PurdueROV-Archive/PCB-X8-Micro/Micro/Gerber/README.txt

Samuel Deghuee
Sdeghuee@gmail.com
(408)693-8003
1/16/2016
STM32f407layout
X:61.43 Y: 90.98 (mm)
Area:5,588.9 mm^2
