PurdueROV-Archive/PCB-X8-Micro/Micro/eagleUp/eagleUp_STM32f407layout_bottom_mask.png

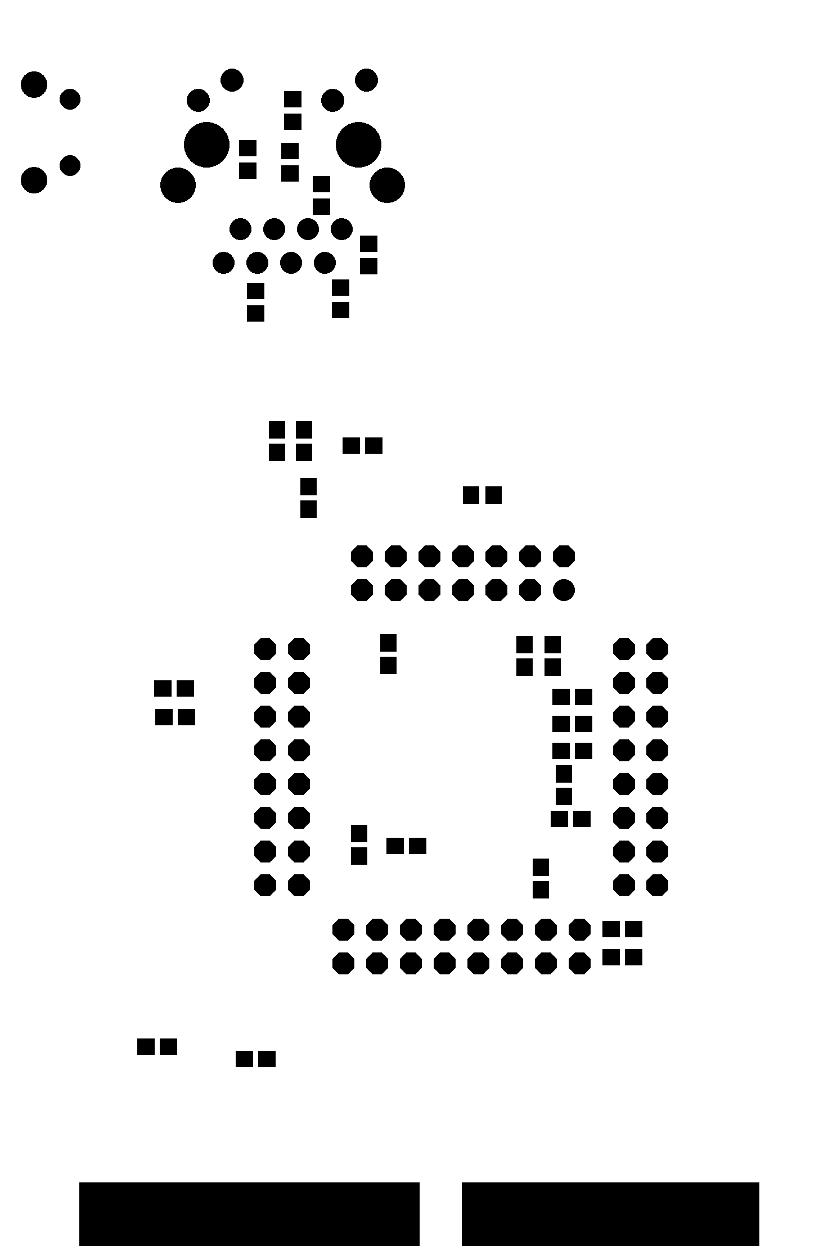
Micro/eagleUp/eagleUp_STM32f407layout_bottom_mask.png
