PurdueROV-Archive/PCB-X8-Micro/Micro/eagleUp/eagleUp_STM32f407layout_top.png

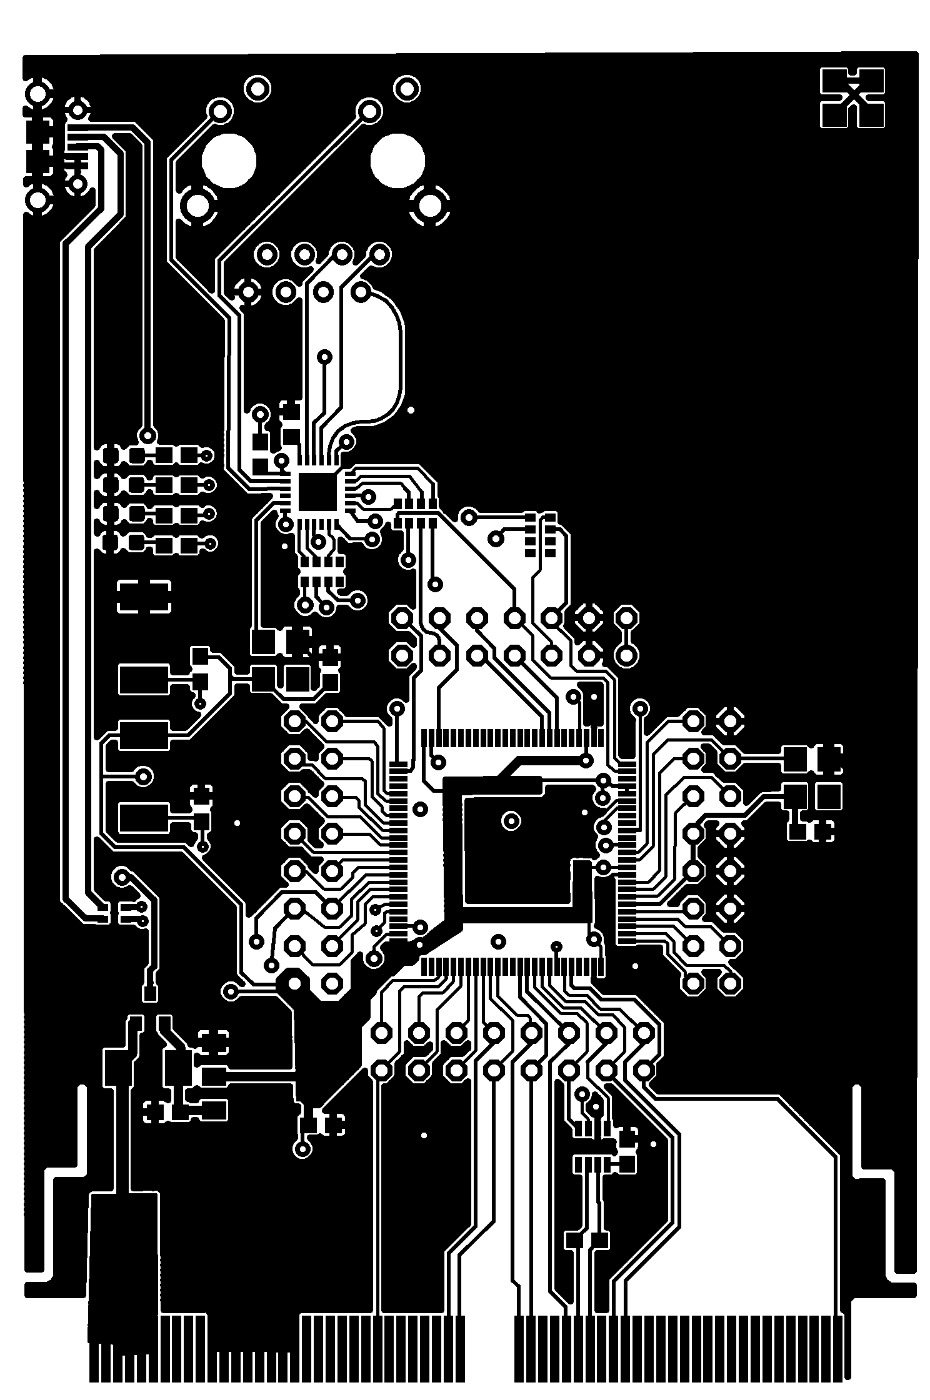
Micro/eagleUp/eagleUp_STM32f407layout_top.png
