PurdueROV-Archive/PCB-X8-Micro/Ethernet Chip/ethernet board/ethernet_chip_board.brd

## EAGLE design Ethernet Chip/ethernet board/ethernet_chip_board.brd (2015-12-05)

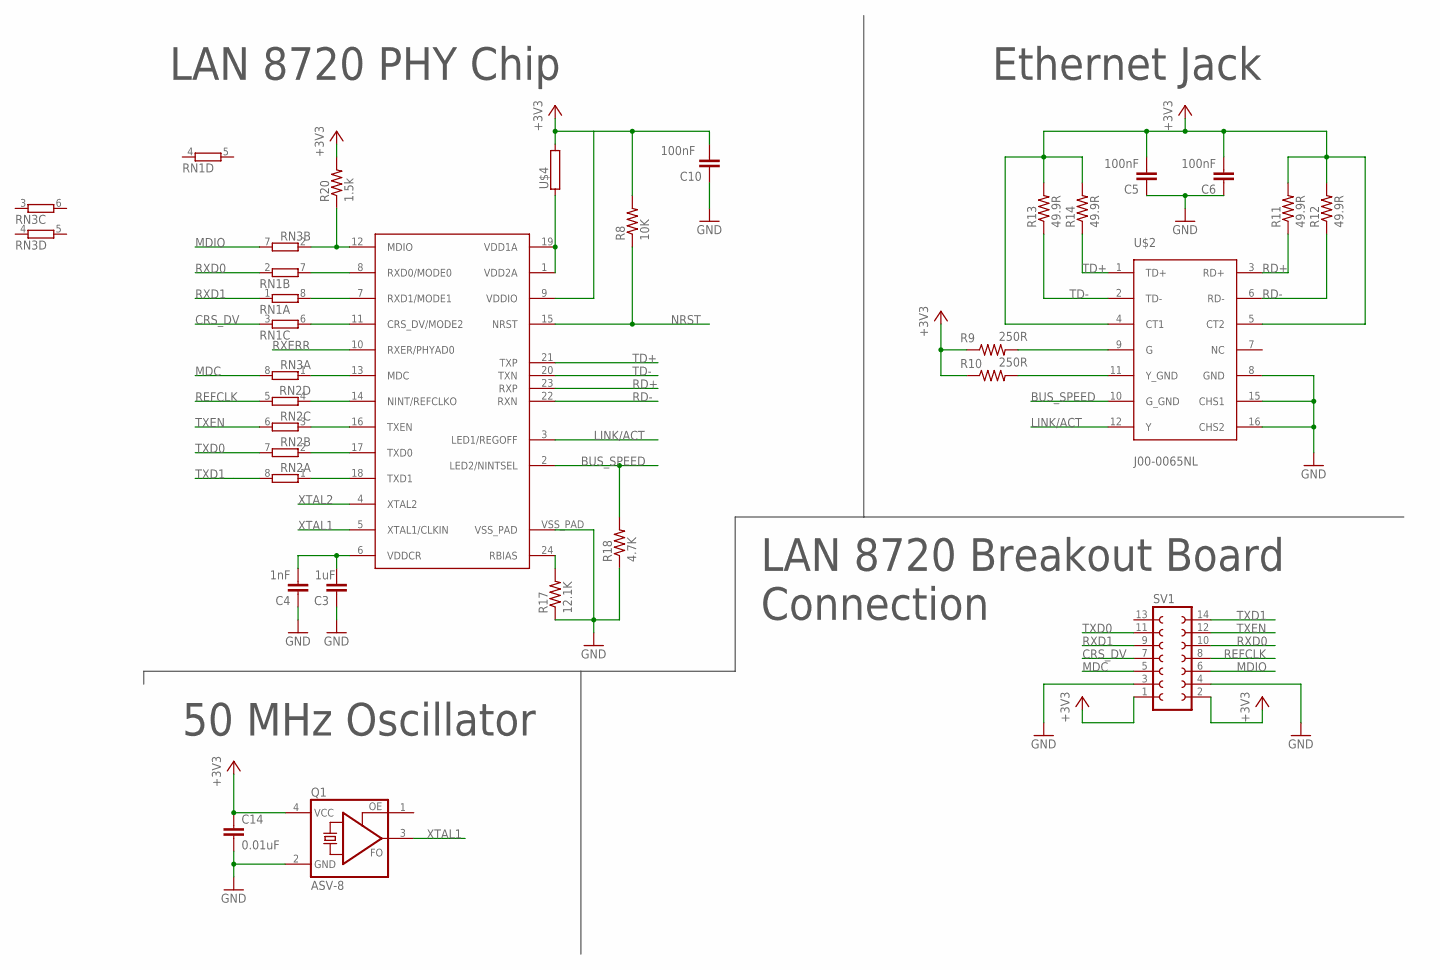
[picture p13: schematic ethernet_chip_board.sch]

Parts:
C3: 1uF; C0603
C4: 1nF; C0603
C5, C6, C10: 100nF; C0603
C14: 0.01uF; C0603
Q1: ASV-8; ASF
R8: 10K; 0603-RES
R9, R10: 250R; R0603
R11, R12, R13, R14: 49.9R; R0603
R17: 12.1K; R0603
R18: 4.7K; R0603
R20: 1.5k; R0603
RN1, RN2, RN3: 4R-NCAY16; CAY16
SV1: FE07-2
U$1: LAN8720LAN8720; 24-QFN
U$2: J00-0065NL
U$4: 553-2382-1-ND; 0603

Connections:
+3V3: C5.2, C6.2, C10.2, C14.1, Q1.4 (VCC), R8.2, R9.1, R10.1, R11.2, R12.2, R13.2, R14.2, R20.2, SV1.1, SV1.2, U$1.9 (VDDIO), U$2.4 (CT1), U$2.5 (CT2), U$4.2
BUS_SPEED: R18.2, U$1.2 (LED2/NINTSEL), U$2.10 (G_GND)
CRS_DV: RN1.3 (1), SV1.7
GND: C3.1, C4.1, C5.1, C6.1, C10.1, C14.2, Q1.2 (GND), R17.1, R18.1, SV1.3, SV1.4, U$1.VSS_PAD, U$2.8 (GND), U$2.15 (CHS1), U$2.16 (CHS2)
GREEN: R9.2, U$2.9 (G)
LINK/ACT: U$1.3 (LED1/REGOFF), U$2.12 (Y)
MDC: RN3.8 (2), SV1.5
MDE: RN3.1, U$1.13 (MDC)
MDIO: RN3.7 (2), SV1.6
unnamed: RN1.7 (2), U$1.8 (RXD0/MODE0)
unnamed: RN1.8 (2), U$1.7 (RXD1/MODE1)
unnamed: C3.2, C4.2, U$1.6 (VDDCR)
unnamed: R17.2, U$1.24 (RBIAS)
unnamed: RN1.6 (2), U$1.11 (CRS_DV/MODE2)
unnamed: RN2.4 (1), U$1.14 (NINT/REFCLKO)
unnamed: RN2.3 (1), U$1.16 (TXEN)
unnamed: RN2.2 (1), U$1.17 (TXD0)
unnamed: RN2.1, U$1.18 (TXD1)
unnamed: U$1.1 (VDD2A), U$1.19 (VDD1A), U$4.1
unnamed: R20.1, RN3.2 (1), U$1.12 (MDIO)
NRST: R8.1, U$1.15 (NRST)
RD+: R11.1, U$1.23 (RXP), U$2.3 (RD+)
RD-: R12.1, U$1.22 (RXN), U$2.6 (RD-)
REFCLK: RN2.5 (2), SV1.8
RXD0: RN1.2 (1), SV1.10
RXD1: RN1.1, SV1.9
RXERR: U$1.10 (RXER/PHYAD0)
TD+: R14.1, U$1.21 (TXP), U$2.1 (TD+)
TD-: R13.1, U$1.20 (TXN), U$2.2 (TD-)
TXD0: RN2.7 (2), SV1.11
TXD1: RN2.8 (2), SV1.14
TXEN: RN2.6 (2), SV1.12
XTAL1: Q1.3 (FO), U$1.5 (XTAL1/CLKIN)
XTAL2: U$1.4 (XTAL2)
YELLOW: R10.2, U$2.11 (Y_GND)

Notes on the sheet:
Ethernet Jack
LAN 8720 PHY Chip
50 MHz Oscillator
LAN 8720 Breakout Board Connection

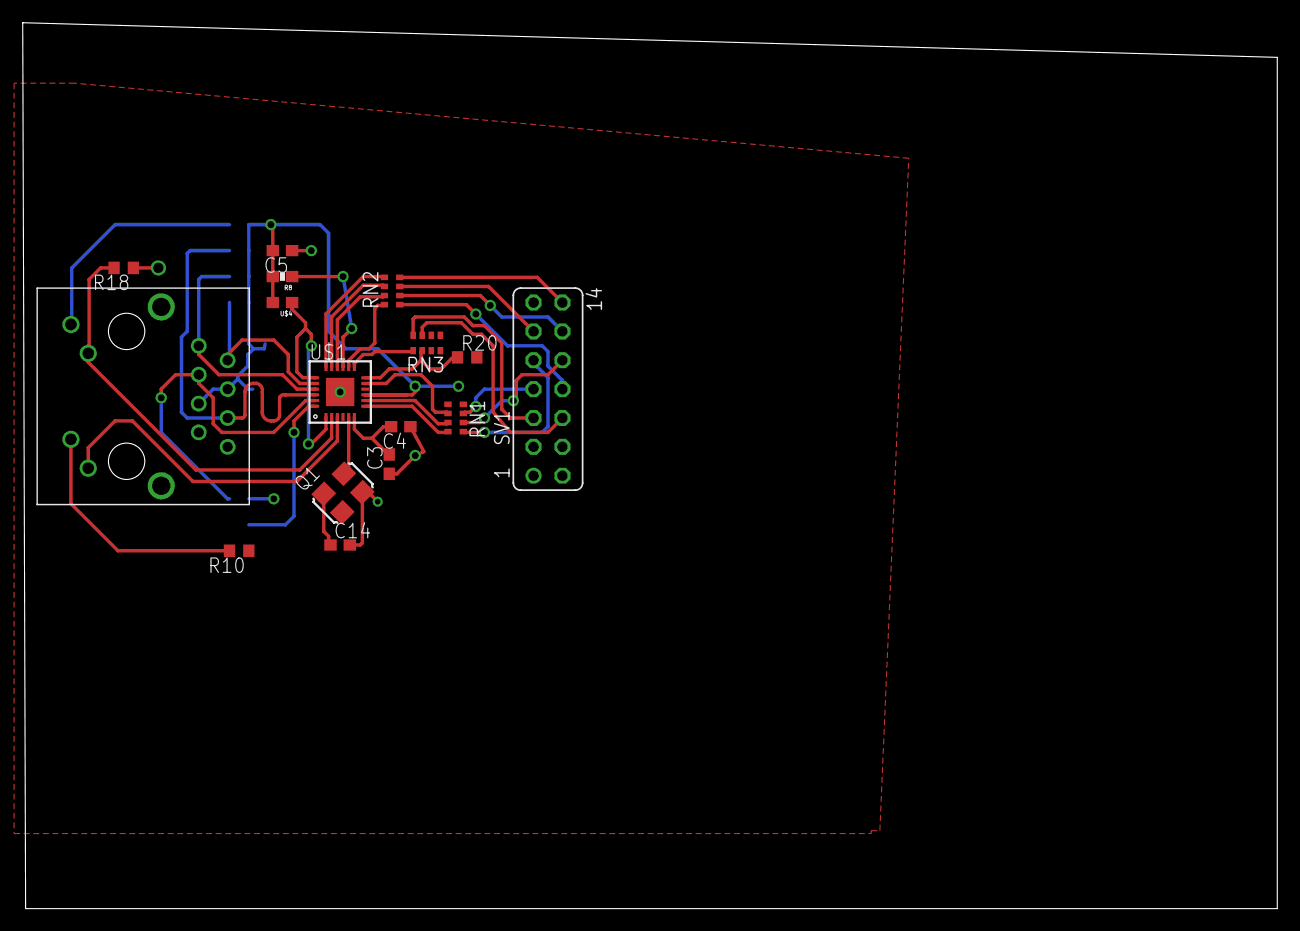
[picture p14: board ethernet_chip_board.brd from above]

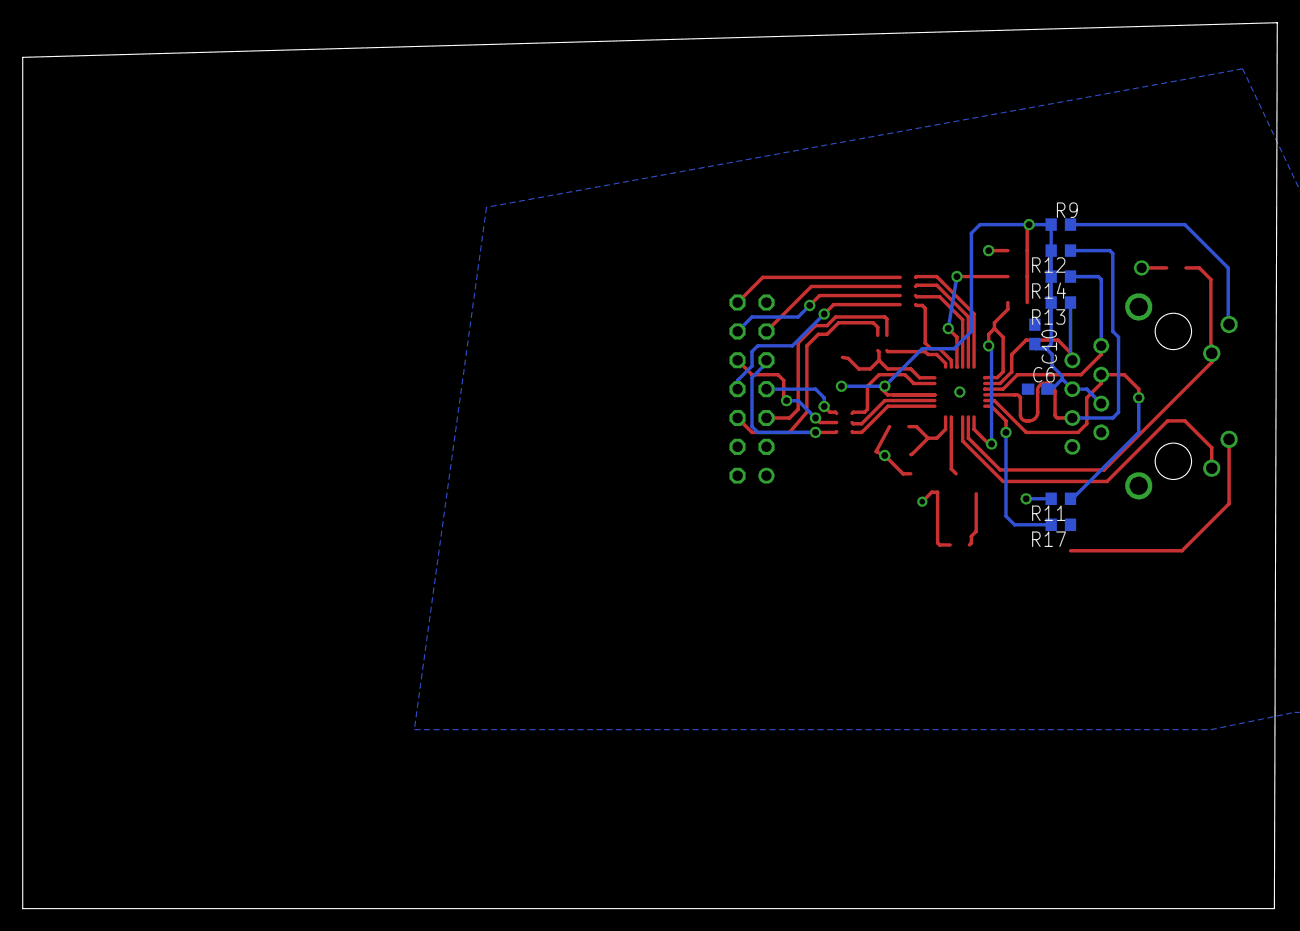
[picture p15: board ethernet_chip_board.brd from below]

Board: 2 copper layers, 110.4 x 78.0 mm, 24 parts (8 on the bottom side), 33 nets.
