PurdueROV-Archive/PCB-X8-Micro/(commit log)

2015-10-24 Created LAN8720 part in Eagle.
    This library contains a dot indicating the position of the first pin.
    This dot was not present in the previous version.
2015-11-08 Fixed folders
    [STM32F4layout.sch]
2015-11-11 Next Step for Power, tied I2C high
    Next step in micro board schematic
    [STM32F4layout.sch]
2015-11-14 Updated Ethernet Schematic (From Paul)
    [ethernet chip.sch]
2015-11-14 Updated Ethernet Schematic (Paul)
    [ethernet chip.sch]
2015-11-15 Cleaned up microboard folder
    [ethernet chip.sch]
2015-11-15 "Cleaned up the ethernet chip schematic"
    [ethernet chip.sch]
2015-11-15 Finished the ethernet board schematic
    [ethernet chip.sch]
2015-11-15 Cleaned up the lan8720 schematic
    [ethernet chip.sch]
2015-11-18 Pushed latest updates
    Added labels and buttons for boot and such
    [STM32F4layout.sch]
2015-11-19 Started Ethernet Board Layout
    [ethernet chip board.brd, ethernet chip board.sch]
2015-11-23 Worked on the board layout for the ethernet circuit
    [ethernet chip board.brd, ethernet chip board.sch]
2015-11-25 Update on more parts
    Whooo Updates
    [STM32F4layout.sch]
2015-11-26 Worked on List that Luke and I worked on
    Includes, almost set up USB, LEDs, Almost a power Supply, CAN Chip
    Connections and More!
    [STM32F4layout.sch]
2015-11-30 Finished Power Layout, added pin header, added USB
    finished list from Luke/Sam Conversation
    [STM32F4layout.sch]
2015-12-03 updated the ethernet board
    [ethernet chip board.brd, ethernet chip board.sch]
2015-12-04 Added some of needed additional circuits
    [STM32F4layout.sch]
2015-12-04 Final Version before Design Review
    Fixed Pin Out Problems
    [STM32F4layout.sch]
2015-12-05 "Fixed saving problems"
    [ethernet_chip_board.brd, ethernet_chip_board.sch]
2015-12-05 "Added 50 MHz Oscillator"
    [ethernet_chip_board.brd]
2015-12-07 Trying to fix permissions issure
    [STM32F407layout.sch]
2015-12-07 Fixing a bug
    [STM32F4layout.sch]
2015-12-07 Still trying to fix saving issue
    [STM32f407layout.sch]
2015-12-07 fixing some more bugs
    [STM32F407layout.sch]
2015-12-10 Began Board Layout
    [STM32f407layout.brd]
2015-12-10 worked on board layout, set initial width requirements
    [STM32f407layout.brd, STM32f407layout.sch]
2015-12-16 Updated Board
    [STM32f407layout.brd, STM32f407layout.sch]
2015-12-16 More Board Updates
    Remind myself to switch LED pins
    [STM32f407layout.brd, STM32f407layout.sch]
2015-12-19 Made changes to the micro board
    [STM32f407layout.brd, STM32f407layout.sch]
2015-12-20 Updated Board on flight
    moved TXD0 pin connection to not cross transmission lines
    remove PC0 so can run MDC out. If it is a clock its pretty important
    that it does not go under micro
    may want to move xtal, bit far away probably wont be a problem but hf
    signals do not like distance and things inbetween them
    check via usage, use different ones , may want to stick to 1 size
    move i2c resistors to bottom, connected them to 3v3
    are linear regs noisey or is that switching? pretty sure it is switching
    [STM32f407layout.brd, STM32f407layout.sch]
2015-12-21 Holiday Update 1
    Connected extra capacitors, changed PC0 to GND for now, May route to
    better pinout later. Added GND planes made sure no unrouted
    [STM32f407layout.brd, STM32f407layout.sch]
2015-12-27 Ethernet Addition
    I added the ethernet chip and added essential routes, need to do
    tolerance checks
    [STM32f407layout.brd, STM32f407layout.sch]
2015-12-27 Ethernet Length Checks
    Checked length of ethernet signals, still need to check tolerances on
    RD+- and TD+-
    [STM32f407layout.brd]
2015-12-27 More Updates
    Moved ehternet jack, made things similar in length
    [STM32f407layout.brd]
2015-12-28 Other Update
    Updated power and ground, might need more fixing based on other traces.
    need to check if can use different pins for Sonar PWM and DAC, as well
    as Servo PWMs.
    [STM32f407layout.brd, STM32f407layout.sch]
2015-12-30 Added rough sketch for bottom pinout
    [STM32f407layout.brd, STM32f407layout.sch]
2015-12-30 Fixed Polygons for Power and GND
    [STM32f407layout.brd]
2015-12-30 Moved final clearances
    Double Checked vias and trace distances
    [STM32f407layout.brd]
2015-12-30 added real header pin
    Did a rough draft of connections to backplane
    [STM32f407layout.brd, STM32f407layout.sch]
2015-12-31 Imprved spacing, changed bottom pinouts
    [STM32f407layout.brd, STM32f407layout.sch]
2016-01-01 Fixed DRC Errors, Began fixing other problems
    [STM32f407layout.brd, STM32f407layout.sch]
2016-01-03 Fixed some wiring on the microboard
    [STM32f407layout.brd, STM32f407layout.sch]
2016-01-03 Cleaned up the board
    [STM32f407layout.brd, STM32f407layout.sch]
2016-01-05 Added Silkscreen Pin labels
    [STM32f407layout.brd]
2016-01-06 Updated Silkscreen
    [STM32f407layout.brd]
2016-01-16 Update to fix information from "final" design review
    moved micro usb connector, fixed power square
    [STM32f407layout.brd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]
2016-01-16 Finished changes for trying to fix micro board
    Last push of integrated ethernet
    [STM32f407layout.brd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]
2016-01-21 Working on getting Eagle Up to work
    [STM32f407layout.brd]
